flareradd/esp32-environment-sensor/README.md

# Statchain

A keychain-sized environment monitor on an ESP32-C3. It measures sound level, temperature, humidity,
pressure and battery, shows them on a 2.13" e-ink screen, logs them to flash, and serves its own companion
web app over Wi-Fi: open the device's address in any browser, no install and nothing to host.

**Status:** firmware v0.1 with the companion app v0.1 built into it. It builds from a fresh checkout and the
images validate (see [Verification](#verification)), but **nothing has been run on real hardware yet**: the
app has only met a mock of the device, and the firmware has only been compiled. The first flash is the
first real test; [docs/flashing.md](docs/flashing.md) says what to expect. Expect some bring-up work.

## Hardware

| Part | Notes |
|---|---|
| ESP32-C3 | SuperMini-style board, or the bare ESP32-C3-12F module |
| ICS-43434 | I2S MEMS microphone |
| AHT20 + BMP280 breakout | temperature, humidity, pressure on I2C |
| WeAct 2.13" black/white/red e-ink | SSD1680, 250×122 |
| Single-cell LiPo | with a 2 × 100 kΩ divider to GPIO3 |

**Wiring and the full pin map: [docs/wiring.md](docs/wiring.md).** In short:

| Function | GPIO |
|---|---|
| I2C SDA / SCL | 0 / 1 |
| E-ink CS / SCK / MOSI / DC / RST / BUSY | 2 / 4 / 6 / 8 / 21 / 20 |
| Mic BCLK / WS / DOUT | 5 / 7 / 10 |
| Battery ADC | 3 |
| Free (BOOT button) | 9 |

## Build and flash

**Full guide, including flashing a ready-made image and what to expect on first boot: [docs/flashing.md](docs/flashing.md).**

With [arduino-cli](https://arduino.github.io/arduino-cli/latest/installation/) there is nothing else to install: the
ESP32 core and libraries are pinned in `firmware/statchain/sketch.yaml` and download on first use.

```sh
cd firmware/statchain
cp secrets.example.h secrets.h        # your Wi-Fi name and password; skip it and the device starts a hotspot
arduino-cli compile                   # first run downloads ~1.8 GB of pinned toolchain
arduino-cli upload -p /dev/ttyACM0    # your port: arduino-cli board list
arduino-cli monitor -p /dev/ttyACM0 -c baudrate=115200
```

No toolchain? `node tools/package-firmware.mjs` writes ready-to-flash images to `dist/`, flashed with esptool or
a browser flasher: see the guide.

**USB CDC On Boot must be enabled** (the build fails with a message if it isn't; the pinned profile already sets
it). The reason is in the wiring doc: GPIO20/21 are used by the display.

Pinned versions (what was tested): ESP32 core 3.3.12, GxEPD2 1.6.9, Adafruit GFX 1.13.0, Adafruit AHTX0 2.0.6,
Adafruit BMP280 3.0.0, Adafruit BusIO 1.17.4, Adafruit Unified Sensor 1.1.15.

The companion app is compiled into the firmware (`app_assets.h`), so this is the only build you need. You
only touch Node if you change something in `app/`: see [docs/app.md](docs/app.md#changing-the-app).

**Flash layout.** `partitions.csv` (next to the sketch, picked up automatically) gives the program a 2 MB
partition and the daily logs ~1.9 MB. The firmware plus the embedded app is ~1.3 MB, about 62 % of that. The
price is no over-the-air updates: those need two program slots, which would leave only ~0.9 MB for logs.
Changing the layout moves the log storage, so **the first flash after this change starts with empty
logs** (settings are kept).

## What it does

* **Sound:** every `soundIntervalS` seconds (default 5, adjustable 2–300) the mic is started, 150 ms is
  discarded while it settles, then 1 s is measured and A-weighted into one dB reading. The I2S clock is
  stopped between readings.
* **Environment:** temperature, humidity and pressure every 30 s. Pressure is station pressure, not
  sea-level adjusted.
* **E-ink page:** "Your Environment": temperature, humidity and pressure in three columns, a sound row
  with the current level and today's min/max, and a footer with battery and the time of the refresh.
  Red is used only as a warning colour (sound at or above `loudDb`, battery at or below `battLowPct`).
  It refreshes at boot, then every `displayIntervalMin` minutes (default 60) or on request. Requests are
  limited to one per 3 minutes to protect the panel.
* **Logging:** one CSV line per `logIntervalMin` minutes (default 5) in a file per local day on the
  device's flash, keeping `keepDays` days (default 21) and dropping the oldest days if flash runs low.
  Today's summary is rebuilt from the log after a restart. Columns: `epoch,tempC,humidity,pressureHPa,soundAvg,soundMin,soundMax,battMv`; an empty field means no reading.
* **Settings** are saved to flash and survive restarts.
* **Wi-Fi and time:** joins the network from `secrets.h`, syncs the clock over NTP in Sydney time
  (`AEST-10AEDT`), and answers at `http://statchain.local`. If it can't join within 30 s it starts its
  own hotspot `Statchain-XXXX` (password `statchain`, or `AP_PASS` from `secrets.h`) so the app
  still works away from home. With no internet the phone can set the clock via `POST /api/time`.

## The companion app

Open **`http://statchain.local`** (or the IP shown in the serial log) in a browser on the same Wi-Fi. The
device serves the app itself, so there is no address to set up, no server to run, and no https-to-http
blocking. It has five tabs: live readings, a day summary, trends, settings, and export.

The app copies each day's log from the device into the browser's own storage, because the device only keeps
a few weeks. On a plain-http page browsers treat that storage as best effort (it can be cleared, and
`statchain.local` and an IP address each keep a separate copy), so the app says so and **Export** makes a
backup file. Details, and why, in [docs/app.md](docs/app.md).

Try the app without hardware: the mock device serves it exactly the way the firmware does.

```sh
npm install                          # once: esbuild, used to build the app
node tools/mock-device/server.mjs    # open http://localhost:8765
```

### API

The app talks to this JSON API, which you can also use directly:

| Method | Path | Returns |
|---|---|---|
| GET | `/api/state` | latest readings and device status |
| GET | `/api/today` | today's min / max / mean for each reading |
| GET | `/api/days` | logged days and flash usage |
| GET | `/api/log?date=YYYYMMDD` | that day's CSV |
| GET / POST | `/api/settings` | settings; POST takes any subset as form fields |
| POST | `/api/refresh` | redraw the e-ink display (429 with `retryInS` if too soon) |
| POST | `/api/time` | `epoch=<unix seconds>`; only accepted while the clock isn't set |

There is **no authentication**: anyone on your network (or on the hotspot) can change settings. That is
fine for a prototype at home; add a token before using it anywhere shared. CORS is open so a page served
from elsewhere (development) can call the API.

**Known limits.** The device's web server handles one connection at a time, so the app is built into a few
gzipped files to keep a page load to a handful of requests. While a page loads, the main loop pauses
briefly, so a sound reading taken at that moment may be slightly off. Some Android phones cannot resolve
`.local` names; use the IP address there.

## Sound readings are an estimate

Level is computed from the mic's datasheet sensitivity (−26 dBFS at 94 dB SPL, ±1 dB) with an A-weighting
filter. That is uncalibrated: the enclosure, the mic port and the individual part all shift it, and the mic's
noise floor is around 30 dBA, so quiet rooms read high. Use the `soundCalDb` setting to trim it against a
reference meter. The constants are in `config.h`. Self-heating from the ESP32 and Wi-Fi will also make
temperature read high; `tempOffsetC` compensates.

## Verification

Done in the development sandbox, without hardware:

* The sketch compiles for `esp32:esp32:esp32c3` with no warnings from project code, **from a fresh clone with
  no `secrets.h`**, and **from a brand-new arduino-cli environment** (empty directories, nothing installed): the
  one `arduino-cli compile` downloaded the pinned core and libraries (about 1.8 GB) and built it.
* **The images:** esptool reads them as valid ESP32-C3 images (DIO, 4 MB, checksums and hashes valid); the
  partition table decodes as designed; the packaging script cross-checks that the full image contains the
  exact bootloader, table and program at the right offsets, and that it leaves the logs partition alone.
* **Boot path** reviewed for hangs with parts missing: a missing display cannot block the firmware (its busy-wait is
  bounded and runs in its own task), and a board with a sensor missing still draws its screen.
* **A-weighting filter:** checked against IEC 61672 reference values: within 0.15 dB up to 4 kHz and 0.6 dB at
  8 kHz (error grows above 10 kHz from the filter design). A 1 kHz tone at a known level gives the expected
  dB SPL, and the float32 filter matches a double-precision run.
* **Logger:** CSV round trip, power-cut truncated lines, missing fields, Sydney daylight-saving
  boundaries, age and free-space pruning, and that today's file is never deleted. The checks fail when the
  protection is removed.
* **E-ink layout:** the real drawing code was rendered on a PC for normal, warning, worst-case-width and
  no-data states.
* **Companion app:** 83 unit and integration tests and a 23-scenario headless-Chromium suite, run against a
  mock device that serves the built app the way the firmware does (details in [docs/app.md](docs/app.md#tests)).
  That includes the app loaded from the device's own address, a genuinely non-secure http origin, and
  gzip/ETag/304 behaviour.
* **Embedding:** the committed `app_assets.h` is checked against a fresh build of `app/` (so the firmware
  cannot ship a stale app), and the app's bytes were confirmed present in the compiled firmware image.
* The firmware's asset handler (`web.cpp`) is compiled and was checked against the ESP32 `WebServer`
  library source (gzip headers, `If-None-Match` handling), but not run.

Not verified: **that the firmware boots and runs**. An ESP32-C3 emulator could not be used here, so the first
flash on a real board is the first time it runs. Also not verified, because it needs the hardware: I2S capture from the mic, the e-ink panel driver and its
timing, the Wi-Fi/NTP/mDNS path, serving the app to a real phone over the device's web server, battery ADC
accuracy, and the strapping-pin assumptions in the wiring doc.

## Layout

```
firmware/statchain/   the Arduino sketch
  partitions.csv      flash layout (2 MB program, ~1.9 MB logs)
  app_assets.h        GENERATED: the companion app, gzipped, from app/
  config.h            pin map and constants
  statchain.ino       setup/loop and scheduling
  sound.*  dsp.h      I2S microphone and the level/A-weighting maths
  sensors.*           AHT20, BMP280, battery
  screen.*  layout.*  e-ink task and the page layout
  logger.*            daily CSV logs on LittleFS
  settings.*          persistent settings
  net.*  web.*        Wi-Fi/NTP/mDNS, HTTP server and API
docs/wiring.md        pin map and wiring
docs/flashing.md      flashing the firmware, first boot, troubleshooting
docs/app.md           the companion app: running, hosting, data, tests
app/                  the companion app source (plain ES modules)
tools/                build-app.mjs (bundles app/ into app_assets.h), package-firmware.mjs (flashable
                      images), mock device, dev server
tests/                unit, integration and end-to-end tests for the app
```
