flareradd/esp32-environment-sensor/(commit log)

2026-10-29 Add Statchain ESP32-C3 firmware and GPIO pin map
    Arduino sketch for the keychain environment monitor:
    - ICS-43434 I2S microphone: 1 s A-weighted Leq every N seconds (adjustable)
    - AHT20 + BMP280 on I2C, LiPo battery monitor on ADC1
    - WeAct 2.13" b/w/r e-ink "Your Environment" page, drawn in its own task;
    red only for loud sound / low battery
    - Daily CSV logs on LittleFS with age and free-space pruning
    - Settings persisted in NVS
    - Wi-Fi + NTP (Sydney time) + mDNS, fallback hotspot, built-in web
    dashboard and JSON API for the companion app
    Pin map and wiring rationale are in docs/wiring.md and config.h.
    Claude-Session: https://cl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
2026-10-29 Add Statchain companion browser app, mock device and tests
    A single-page PWA in app/ (no build step, no dependencies):
    - Home: live readings (sound leads), today's ranges, display refresh,
    banners for offline / browser-blocked / clock not set / sensor faults
    - Today: low/average/high per measurement and intraday charts; step
    back through archived days
    - Trends: 24 h / 7 d / 30 d / all, raw -> hourly -> daily aggregation
    with min-max bands; gaps shown as gaps
    - Settings: device address and settings, archive sync, theme, time zone
    - Export: readings / daily summaries CSV, JSON backup and restore
    - Archives every device day to IndexedDB on the phone (the device keeps
    only a few weeks);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
2026-10-29 Serve the companion app from the device itself
    The firmware now hosts the app, so opening http://statchain.local is the
    whole setup: same origin as the API, no address to configure, no
    https-to-http blocking, nothing to host elsewhere.
    Firmware
    - web.cpp serves the app from flash (gzip, ETag + 304, no-cache) and
    drops the old built-in dashboard
    - app_assets.h is generated from app/ and committed, so building the
    firmware still needs nothing but arduino-cli
    - partitions.csv: 2 MB program / ~1.9 MB logs (the official "No OTA"
    layout); the embedded app pushed the sketch to 99% of the 1.25 MB
    default slot, it is now 62% of 2 MB. Costs OTA; documented.
    sketch.yaml sets the matching Par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
2026-10-29 Make the firmware reproducibly flashable
    Build
    - sketch.yaml now pins a profile (ESP32 core 3.3.12 + exact library
    versions) so `arduino-cli compile` works from an empty environment
    with nothing installed by hand. Verified in a brand-new arduino-cli
    environment (about 1.8 GB download, 6 GB on disk, first time only),
    and from a fresh clone of the pushed branch with no secrets.h.
    - tools/package-firmware.mjs builds and writes ready-to-flash images to
    dist/: a full image for the first flash (0x0) and an app-only image
    for updates (0x10000, keeps settings and logs), with SHA256SUMS and the
    exact esptool commands. Cross-checks the offsets of the parts and that
    the full image leave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
